cellkeeper-bms/cellkeeper-hardware/enclosure/output/enclosure_bambu.3mf

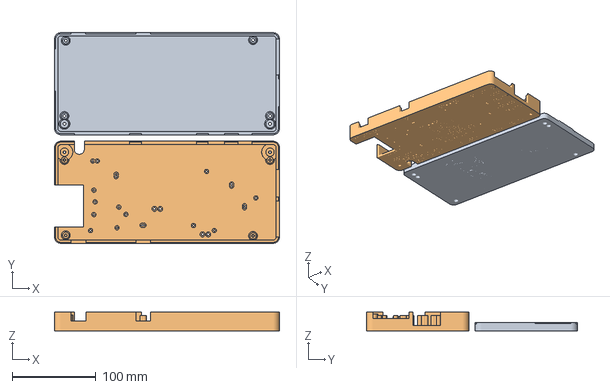
[picture p1: CAD file, 2026-10-28]
enclosure/output/enclosure_bambu.3mf
269.2 x 252.1 x 22.5 mm
base_2color
lid_2color
