cellkeeper-bms/cellkeeper-hardware/enclosure/output/kicad/case_base.step

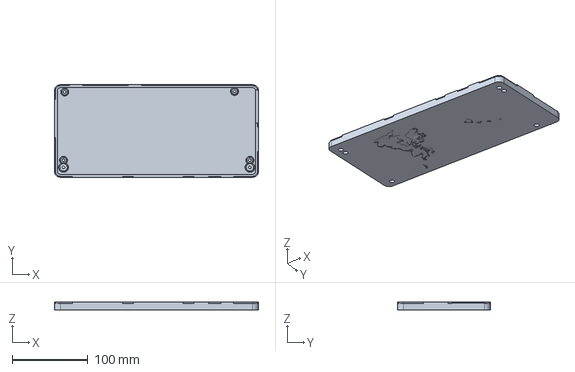
[picture p2: CAD file, 2026-10-26]
enclosure/output/kicad/case_base.step
269.2 x 122.2 x 10.0 mm
