cellkeeper-bms/cellkeeper-hardware/enclosure/output/kicad/case_lid.step

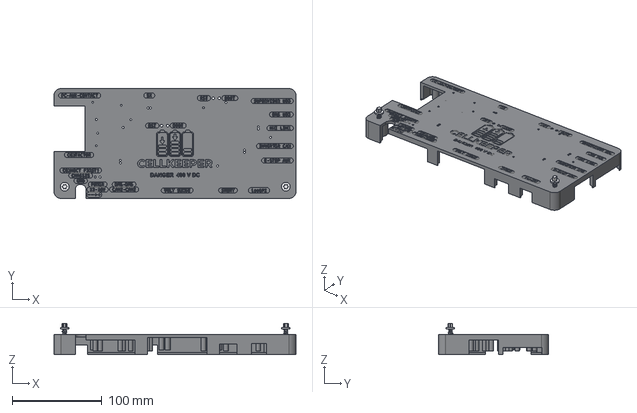
[picture p3: CAD file, 2026-10-26]
enclosure/output/kicad/case_lid.step
269.2 x 122.2 x 34.5 mm
case_lid
bracket_screw x 2
