cellkeeper-bms/cellkeeper-hardware/enclosure/output/kicad/case_inlay.step

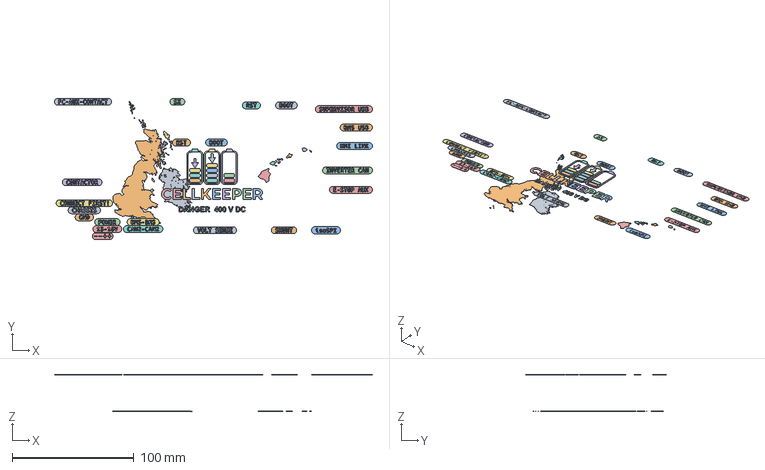
[picture p4: CAD file, 2026-10-26]
enclosure/output/kicad/case_inlay.step
261.1 x 116.1 x 30.6 mm
