cellkeeper-bms/cellkeeper-hardware/enclosure/output/bracket_screw.step

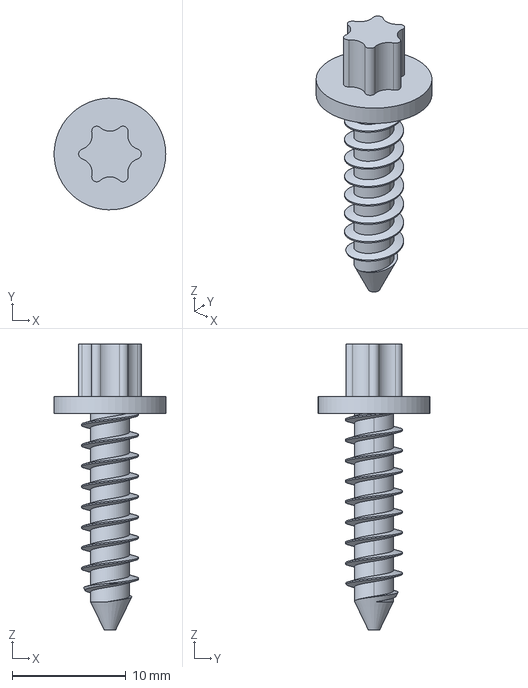
[picture p5: CAD file, 2026-10-26]
enclosure/output/bracket_screw.step
9.79 x 9.80 x 25.1 mm
