cellkeeper-bms/cellkeeper-hardware/Precharge/Precharge.kicad_pcb

## KiCad design Precharge/Precharge.kicad_pcb (2026-10-20)

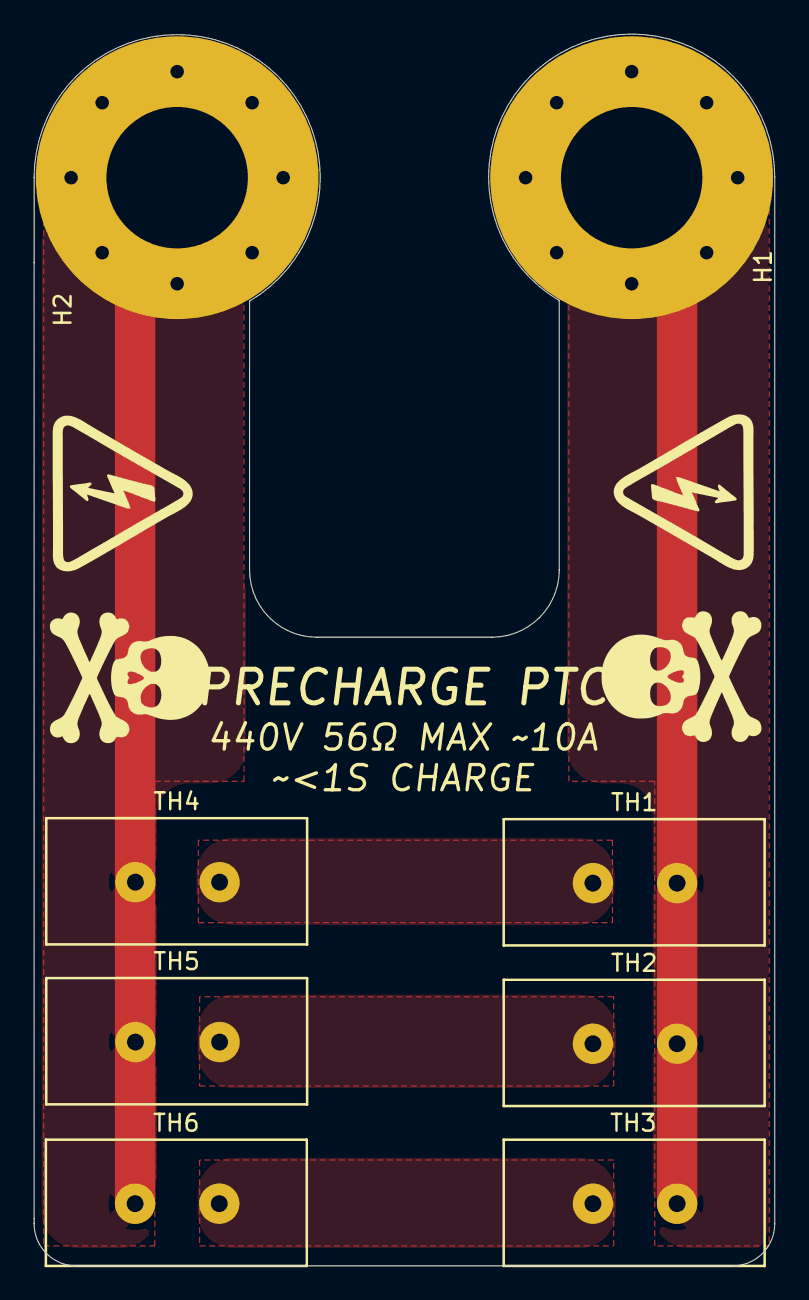
[picture p7: board Precharge.kicad_pcb from above]

Board: 4 copper layers, 44.0 x 73.2 mm, 8 parts (0 on the bottom side), 5 nets.

Parts:
H1, H2: MountingHole_Pad; MountingHole__MountingHole_8.4mm_M8_Pad_Via
TH1, TH2, TH3, TH4, TH5, TH6: B59451C1130B070; BMS_Library__RV_Disc_D15.5mm_W7.5mm_P5.0mm

Connections:
/FC Neg: H2.1 (1_1), TH4.2, TH5.2, TH6.2
Drive Unit Neg: H1.1 (1_1), TH1.1, TH2.1, TH3.1
unnamed: TH1.2, TH4.1
unnamed: TH2.2, TH5.1
unnamed: TH3.2, TH6.1
