cellkeeper-bms/cellkeeper-hardware/isoSPI-Hat/isoSPI-Hat.kicad_pcb

## KiCad design isoSPI-Hat/isoSPI-Hat.kicad_pcb (2026-10-20)

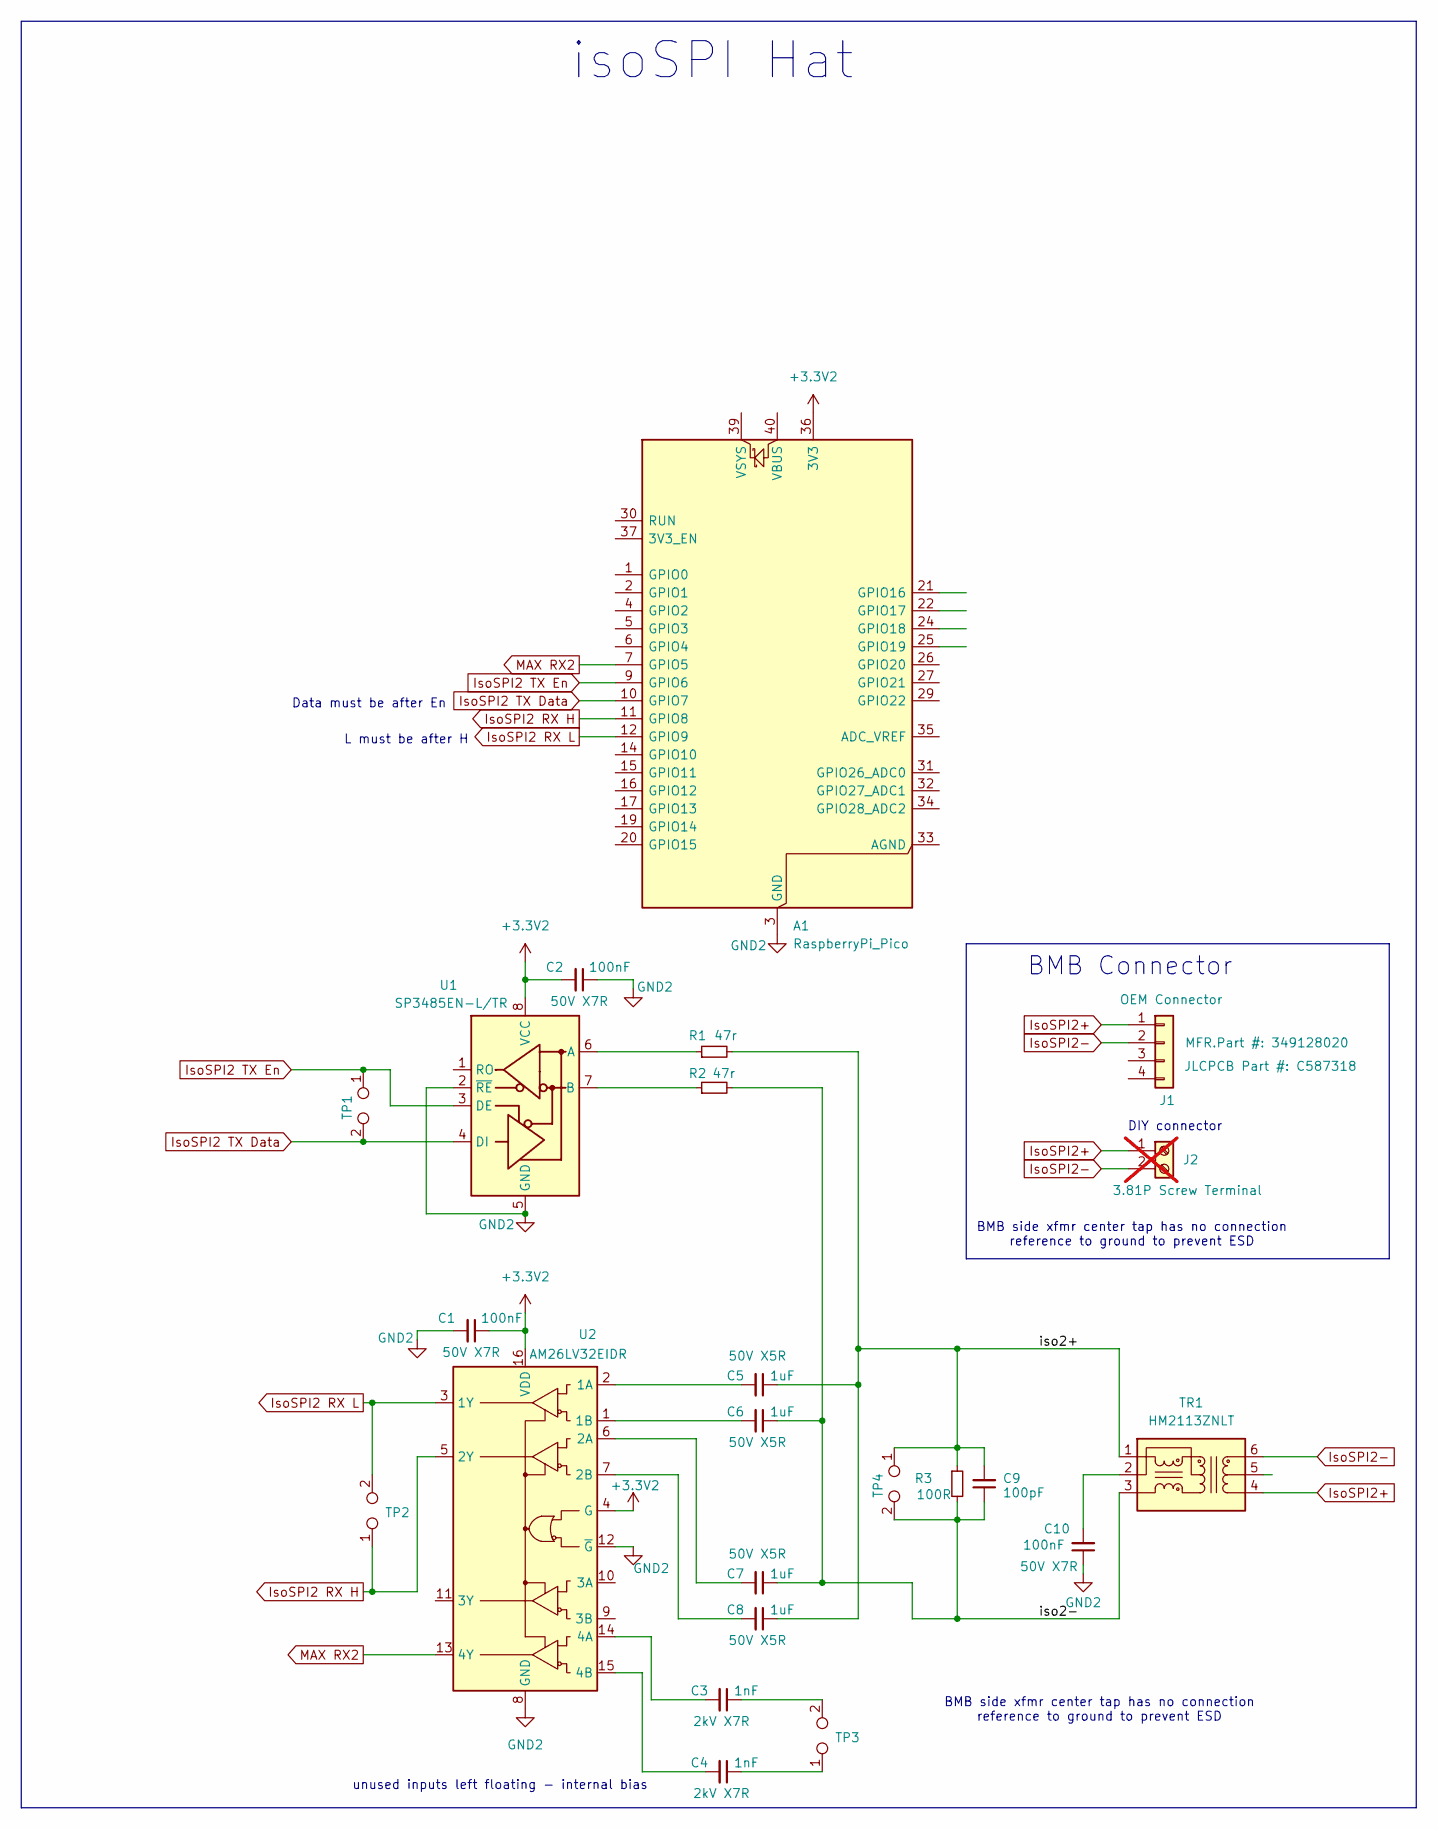
[picture p8: schematic isoSPI-Hat.kicad_sch, CellKeeper isoSPI Hat]

Parts:
A1: RaspberryPi_Pico; Module__RaspberryPi_Pico_Common_Unspecified
C1, C2, C10: 100nF; Capacitor_SMD__C_0603_1608Metric; JLCPCB Part # C14663
C3, C4: 1nF; Capacitor_SMD__C_1206_3216Metric; JLCPCB Part # C9196
C5, C6, C7, C8: 1uF; Capacitor_SMD__C_0603_1608Metric; JLCPCB Part # C15849
C9: 100pF; Capacitor_SMD__C_0603_1608Metric; JLCPCB Part # C14858
J1: OEM Connector; BMS_Library__CONN_SD-34912-001_02_MOL; MFR.Part # 349128020; JLCPCB Part # C587318
J2: 3.81P Screw Terminal; BMS_Library__PhoenixContact_MC_1_5_2-G-3.81_1x02_P3.81mm_Ho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; not fitted
R1, R2: 47r; Resistor_SMD__R_0603_1608Metric; JLCPCB Part # C23182
R3: 100R; Resistor_SMD__R_0603_1608Metric; JLCPCB Part # C22775
TP1, TP2, TP3, TP4: TestPoint_2Pole; BMS_Library__TestPoint_2Pads_Pitch2.54mm_Pad1.5_Drill1.0mm
TR1: HM2113ZNLT; BMS_Library__HM2113ZNLT; JLCPCB Part # C5730533
U1: SP3485EN-L/TR; Package_SO__SOIC-8_3.9x4.9mm_P1.27mm; JLCPCB Part # C8963
U2: AM26LV32EIDR; Package_SO__SOIC-16_3.9x9.9mm_P1.27mm; JLCPCB Part # C527448

Connections:
+3.3V2: A1.36 (3V3), C1.1, C2.2, U1.8 (VCC), U2.4 (G), U2.16 (VDD)
/iso2+: C5.1, C8.1, C9.2, R1.2, R3.1, TP4.1, TR1.1 (TD-)
/iso2-: C6.1, C7.1, C9.1, R2.2, R3.2, TP4.2, TR1.3 (TD+)
GND2: A1.3 (GND), A1.8 (GND), A1.13 (GND), A1.18 (GND), A1.23 (GND), A1.28 (GND), A1.38 (GND), C1.2, C2.1, C10.1, U1.2 (~RE), U1.5 (GND), U2.8 (GND), U2.12 (~G)
IsoSPI2 RX H: A1.11 (GPIO8), TP2.1, U2.5 (2Y)
IsoSPI2 RX L: A1.12 (GPIO9), TP2.2, U2.3 (1Y)
IsoSPI2 TX Data: A1.10 (GPIO7), TP1.2, U1.4 (DI)
IsoSPI2 TX En: A1.9 (GPIO6), TP1.1, U1.3 (DE)
IsoSPI2+: J1.1, J2.1, TR1.4 (TX+)
IsoSPI2-: J1.2, J2.2, TR1.6 (TX-)
MAX RX2: A1.7 (GPIO5), U2.13 (4Y)
unnamed: C3.1, TP3.2
unnamed: C4.1, TP3.1
unnamed: C10.2, TR1.2 (C_TD)
unnamed: R1.1, U1.6 (A)
unnamed: R2.1, U1.7 (B)
unnamed: C5.2, U2.2 (1A)
unnamed: C6.2, U2.1 (1B)
unnamed: C7.2, U2.6 (2A)
unnamed: C8.2, U2.7 (2B)
unnamed: C3.2, U2.14 (4A)
unnamed: C4.2, U2.15 (4B)

Notes on the sheet:
L must be after H
BMB Connector
BMB side xfmr center tap has no connection reference to ground to prevent ESD
Data must be after En
isoSPI Hat
DIY connector
unused inputs left floating - internal bias
