cellkeeper-bms/cellkeeper-hardware/isoSPI-Hat/isoSPI-Hat.kicad_pcb

## KiCad design isoSPI-Hat/isoSPI-Hat.kicad_pcb (continued)

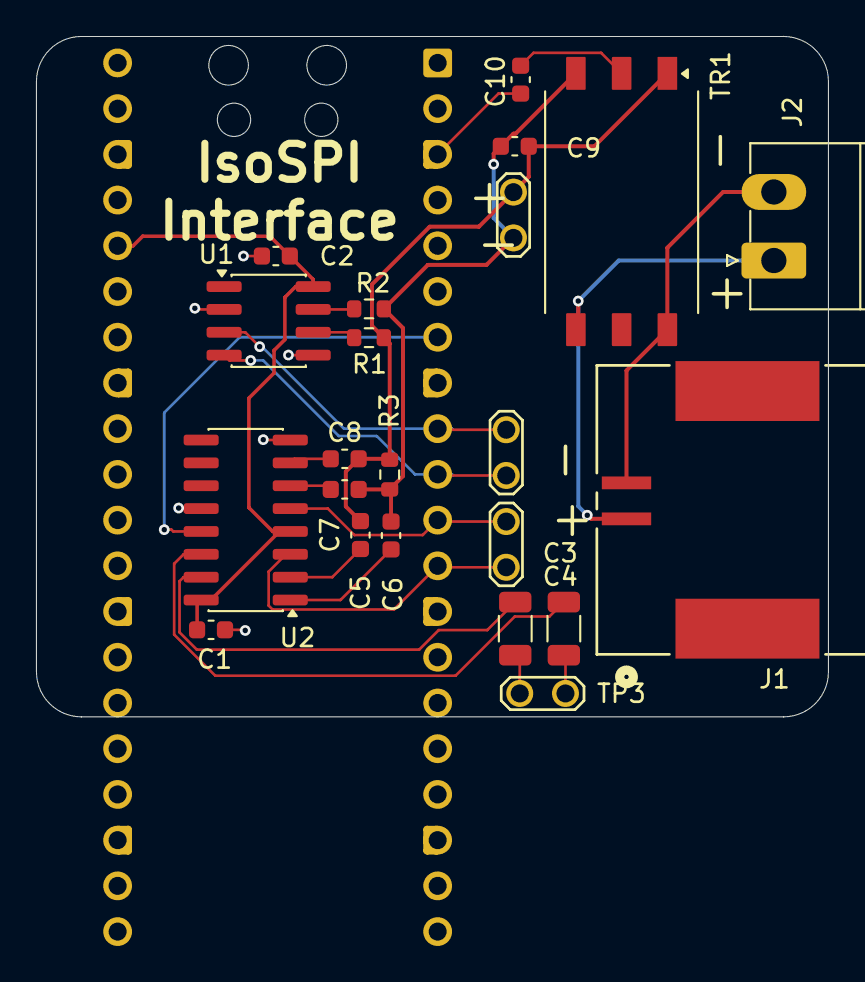
[picture p9: board isoSPI-Hat.kicad_pcb from above]

Board: 4 copper layers, 44.0 x 37.8 mm, 23 parts (1 on the bottom side), 22 nets.
