cellkeeper-bms/cellkeeper-hardware/(commit log)

2026-10-15 Rev1.1: USB VBUS sense on GPIO3, revision strap, shunt 3V3 cap
    - USB VBUS detect for both MCUs: 3.3k from each connector's VBUS to GPIO3
    (pin 80) and 5.1k to GND (controller R78/R153, Supervisor R155/R154), also
    brought out on J12/J22 pin 2.
    - Revision strap on GPIO47: R75 10k to 3V3, R76 1k to GND (reads as Rev1.1).
    - C116 10uF on the isolated shunt 3V3; C57 removed.
    - Test points: GPIO1-3 removed, GPIO44-46 added.
2026-10-21 Add 3D-printable enclosure for the main board (build123d)
    enclosure/cellkeeper_case.py builds a base tray and lid around the board:
    - M3 screws from below self-tap into the lid pillars at H1/H2/H7/H8 (and
    H3/H4 while BOARD_SCREWS_AT_H3_H4 is set); 45 deg screw seats print
    without support
    - flat lid top 20 mm above the PCB with 4.3 mm bracket holes over H3/H4
    for the penthouse mounting brackets
    - connector openings, J6 passing through the lid, ground-screw slot,
    button guide tubes and LED light tunnels
    - lid markings as true curves: the silkscreen logo refit as lines and
    splines, KiBuzzard-style labels built from the KiBuzzard font
    - print files as STEP/STL (whole and split for 256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
2026-10-21 README: v1.1, current board render and enclosure preview
2026-10-21 README: drop Getting Started; add update notes and image script
    - docs/readme-update.md: what changed in the README, how to refresh its
    images, and a review of the README against the Rev 1.1 schematic and
    board with suggested wording and open questions
    - python_scripts/render_readme_images.py renders the bare-board top view
    (ENC1 case footprint removed) and the right-front enclosure view
    - images re-rendered with the script
2026-10-21 README: 13-16 V logic and contactor inputs, 400 V nominal HV battery
2026-10-23 Enclosure: thread the bracket holes for the original bracket screw
    Model the penthouse bracket screw (measured from the original: PT-style
    thread-forming screw, 4.9 mm thread, 1.8 mm pitch, 30 deg flank, 19 mm
    long, 9.8 mm flange, hex-lobular head) and cut its thread into the two
    bracket holes above H3/H4, with the 3.0 mm core continuing to the 16 mm
    depth. The screws appear in the KiCad lid model with their heads 6 mm
    above the lid (the bracket tab), and as output/bracket_screw.step.
2026-10-23 Enclosure: 0.4 mm clear LED windows instead of solid light pipes
    Solid clear rods down each LED tunnel spread the light too much. The
    light_windows part is now a 0.4 mm (two-layer) clear disc closing the top
    of each tunnel, with the tunnel below left hollow. New *_open print files
    leave the tunnels fully open. The KiCad lid model keeps the tunnels hollow.
2026-10-24 Enclosure: underside map, open LED tunnels only, split files in a subfolder
    - The base underside carries the board's back-silkscreen map (UK + Ireland
    and Hawaii), refit as lines and splines and shown at twice its board size,
    centred: debossed (base) or as a 0.2 mm pocket plus inlay (base_2color).
    extract_logo.py now also copies the map; small specks and pinholes that
    can't print are dropped, and refits that cross themselves fall back to a
    tighter fit or the original outline.
    - The base splits at x = 266 (BASE_SPLIT_X), clear of the map.
    - LED tunnels are left open; the light-window and light-pipe versions are
    kept in enclosure/archive/light_windows.py.
    - Split pieces and keys ar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
2026-10-24 Bracket screw: Torx head, 5.0 mm thread with 3.4 mm core, keep the 4.3 mm bore
    The two bracket holes keep their 4.3 mm clearance bore and also get the
    screw thread cut in. The screw model now has an external Torx head (5.5 mm
    across the lobes) and the measured 5.0 mm thread OD and 3.4 mm core.
    Outputs regenerated.
2026-10-26 Wider button holes (4.2 mm) and 0.4 mm two-colour inlays
    The RST/BOOT guide holes are 2 mm wider (4.2 mm), with the tubes widened
    to 7.2 mm to keep a 1.5 mm wall and the labels moved out to stay 1.2 mm
    clear. The two-colour pockets and inlays on the lid and base are now two
    layers (0.4 mm) instead of one. Outputs regenerated.
2026-10-26 Button holes 2.0 mm
    The RST/BOOT guide holes are 2.0 mm across (not 2 mm wider), in the
    original 5.2 mm tubes, with the labels back in their original place.
    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
2026-10-26 Button holes 3.0 mm
    The RST/BOOT guide holes are 3.0 mm across, in 6.0 mm tubes to keep a
    1.5 mm wall, with the labels moved out to stay 1.3 mm clear of the holes.
    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
2026-10-28 Enclosure: re-export the Bambu project
2026-10-28 Rev 1.1 as ordered from JLCPCB on 2026-10-28
    - RP2350 symbol: one library symbol for the RP2350B or RP2354B, used by
    U14 and U20 with the same nets as before
    - W25Q16JV flash (U23, U24) on each MCU's QSPI bus, marked DNP: the
    RP2354B's in-package flash already sits on that bus and chip select
    - H0505S-1WR2 courtyard extended 0.6 mm (U4, U15)
    - Back silkscreen moved back into place with the rest of the board; hole
    in the E-STOP DISABLE label around JP37; fonts embedded
    - Production files for REV1.1; REV1 BOM, CPL and designators moved into
    production/CellKeeper_REV1 beside its Gerbers
2026-10-28 README images from the rev 1.1 board as ordered
    The enclosure render now uses a copy with ENC1 not excluded from position files, so KiCad's 3D viewer filter for those footprints no longer hides the case.
2026-10-28 Clean up: release-only enclosure prints, stale images, unused models
    - Stop tracking the enclosure print outputs (enclosure/output/print and
    the assembly STEP); they are attached to each release instead
    - Delete the old panel renders (CellKeeper_1v1.jpg, graphics/CellKeeperPCB.png),
    enclosure/archive/light_windows.py and 22 3D models nothing references
    - Stop tracking python_scripts/__pycache__; ignore the schematic PDF plot
    - Move the REV1.1 BOM, CPL, designators, zip and netlist into
    production/CellKeeper_REV1.1 beside its Gerbers, like REV1
2026-10-28 Release files script: board print PDF alongside schematic, production files and enclosure prints
    export_release_files.py collects a revision's release files into release/REV<rev>/, including a 1:1 board PDF (top, and bottom seen from below) plotted with its own paper colour theme. docs/releasing.md describes the release steps.
2026-10-28 Stop tracking the fab toolkit's production folder
    Each ordered revision's Gerbers, BOM, CPL and PDFs are attached to its GitHub release (rev1 and rev1.1 now both carry them), so production/ is git-ignored.
2026-10-28 Board PDF: 3D views of the top and bottom before the 1:1 prints
    The renders drop DNP parts' 3D models, so they show the board as assembled regardless of KiCad's 3D viewer DNP filter; the README renders now do the same. The release PDFs leave out the floor shadow.
2026-10-28 Drop the old J17 model and the finished split-boards plan
    J17's TE_173864-1.step is generated with its colours, so the recolour script no longer touches the old CONN_173864-1_TYC_Empty_Pins.step, which nothing references. The 2026-10-14 split-subboards plan was done.
2026-10-28 README: rev 1.1 overview; check out text files with LF
    The overview now covers both RP2354Bs, the isolated current sensing, the two ADS1115s, both CAN buses, the supervisor-enabled contactor drivers, USB-C, I/O and the revision strap, checked against the rev 1.1 netlist. .gitattributes keeps text files LF in Windows checkouts too; every committed file was already LF.
